wiresboy/HomeAutomationWifi/HomeAutoModuleBOM.xlsx

Qty | Value | Parts | Digikey | Price Each (q=10 or 50)
2 | 1uF | C1, C14 | 1276-1182-1-ND (http://www.digikey.com/product-detail/en/samsung-electro-mechanics-america-inc/CL10A105KP8NNNC/1276-1182-1-ND/3889268) | 0.0154
2 | 47pF | C16, C17 | 1276-1037-1-ND (http://www.digikey.com/product-detail/en/samsung-electro-mechanics-america-inc/CL10C470JB8NNNC/1276-1037-1-ND/3889123) | 0.0136
3 | .1uF | C2, C13, C15 | 1276-1258-1-ND (http://www.digikey.com/product-detail/en/samsung-electro-mechanics-america-inc/CL10F104ZO8NNNC/1276-1258-1-ND/3889344) | 0.0052
1 | 10uF | C3 | 1276-2405-1-ND (http://www.digikey.com/product-detail/en/samsung-electro-mechanics-america-inc/CL21A106KQCLRNC/1276-2405-1-ND/3890491) | 0.0334
1 | 5.6pF | C4 | 1276-2319-1-ND (http://www.digikey.com/product-detail/en/samsung-electro-mechanics-america-inc/CL10C5R6DB8NNNC/1276-2319-1-ND/3890405) | 0.0186
1 | 390pF: CC0805KRX7R9BB391 | C5 | 311-1193-1-ND (http://www.digikey.com/product-detail/en/yageo/CC0805KRX7R9BB391/311-1193-1-ND/372906) | 0.048
1 | 22uF: GRM21BR60J226ME39L | C6 | 490-1719-1-ND (http://www.digikey.com/product-detail/en/murata-electronics-north-america/GRM21BR60J226ME39L/490-1719-1-ND/587424) | 0.1
1 | 10uF: TMK316BJ106KL-T | C7 | 587-1337-1-ND (http://www.digikey.com/product-detail/en/taiyo-yuden/TMK316BJ106KL-T/587-1337-1-ND/931114) | 0.2074
1 | 22pF | C8 | 1276-2227-1-ND (http://www.digikey.com/product-detail/en/samsung-electro-mechanics-america-inc/CL10C220JB8NCNC/1276-2227-1-ND/3890313) | 0.0132
1 | 10pF | C9 | 1276-2156-1-ND (http://www.digikey.com/product-detail/en/samsung-electro-mechanics-america-inc/CL10C100JB8NNWC/1276-2156-1-ND/3890242) | 0.0118
1 | BLUE | D1 | 160-1647-1-ND (http://www.digikey.com/product-detail/en/lite-on-inc/LTST-C191TBKT/160-1647-1-ND/573587) | DNB - Huskies (0.2884)
1 | RED | D2 | 160-1447-1-ND (http://www.digikey.com/product-detail/en/lite-on-inc/LTST-C191KRKT/160-1447-1-ND/386836) | DNB - Huskies (0.1556)
1 | GREEN | D3 | 160-1446-1-ND (http://www.digikey.com/product-detail/en/lite-on-inc/LTST-C191KGKT/160-1446-1-ND/386834) | DNB - Huskies (0.1556)
1 | ORANGE (or yellow?) | D4 | 160-1434-1-ND (http://www.digikey.com/product-detail/en/lite-on-inc/LTST-C190KFKT/160-1434-1-ND/386812) | DNB - Huskies (0.1348)
1 | 51387-0578 | J1 | WM5462CT-ND (http://www.digikey.com/product-detail/en/molex-llc/0513870578/WM5462CT-ND/1624428) | 1.351
1 |  | J2 | DNB - personal
1 | PTSA_250_16 | J3 | 277-9150-ND (http://www.digikey.com/product-detail/en/phoenix-contact/1989887/277-9150-ND/3605147) | 1.79
3 | 22-23-2031 | J4 (+ JP1, JP2) | DNB - personal
2 |  | JP1, JP2 | S9001-ND (http://www.digikey.com/product-detail/en/sullins-connector-solutions/SPC02SYAN/S9001-ND/76375) | 0.0385
1 | 2.2uH: IHLP1212BZER2R2M11 | L1 | 541-1322-1-ND (http://www.digikey.com/product-detail/en/vishay-dale/IHLP1212BZER2R2M11/541-1322-1-ND/2425941) | 1.35
1 | MPZ1608S221ATA00 | L3 | 445-1565-1-ND (http://www.digikey.com/product-detail/en/tdk-corporation/MPZ1608S221ATA00/445-1565-1-ND/571895) | 0.079
1 | FA-20H | Q1 | SER4045CT-ND (http://www.digikey.com/product-detail/en/epson/FA-20H-40.0000MF10Z-K3/SER4045CT-ND/5175137) | 0.631
1 | 12K ±1% | R1 | 1276-4750-1-ND (http://www.digikey.com/product-detail/en/samsung-electro-mechanics-america-inc/RC1608F123CS/1276-4750-1-ND/3967722) | 0.007
2 | 27 | R10, R11 | 311-27.0HRCT-ND (http://www.digikey.com/product-detail/en/yageo/RC0603FR-0727RL/311-27.0HRCT-ND/730046) | 0.01
1 | 100K : ERJ-6ENF1003V | R3 | P100KCCT-ND (http://www.digikey.com/product-detail/en/panasonic-electronic-components/ERJ-6ENF1003V/P100KCCT-ND/119551) | 0.022
6 | 270 | R2, R4, R5, R8, R13, R14, R15 | 1276-5048-1-ND (http://www.digikey.com/product-detail/en/samsung-electro-mechanics-america-inc/RC1608J271CS/1276-5048-1-ND/3968020) | 0.0064
4 | 10K | R6, R7, R9, R12 | 311-10.0KHRCT-ND (http://www.digikey.com/scripts/DkSearch/dksus.dll?Detail&itemSeq=211240384&uq=636141553673519094) | 0.0057
1 | PTS645SM43SMTR92DEFAULT | SW1 | CKN9112CT-ND (http://www.digikey.com/product-detail/en/c-k-components/PTS645SM43SMTR92-LFS/CKN9112CT-ND/1146934) | DNB - Huskies (0.147)
1 | ESP8266 | U1 | DNB - Grid
1 | TPS62152RGTR | U2 | 296-43621-1-ND (http://www.digikey.com/product-detail/en/texas-instruments/TPS62152RGTR/296-43621-1-ND/5864761) | 1.881
1 | W25Q32FVSS | U3 | W25Q32FVSSIG-ND (http://www.digikey.com/product-detail/en/winbond-electronics/W25Q32FVSSIG/W25Q32FVSSIG-ND/4037404) | 0.5364
1 | FT231XS-R | U4 | 768-1129-1-ND (http://www.digikey.com/product-detail/en/ftdi-future-technology-devices-international-ltd/FT231XS-R/768-1129-1-ND/3029151) | 2.108
