wiresboy/HomeAutomationWifi/Silkscreen TL test 1.pdf

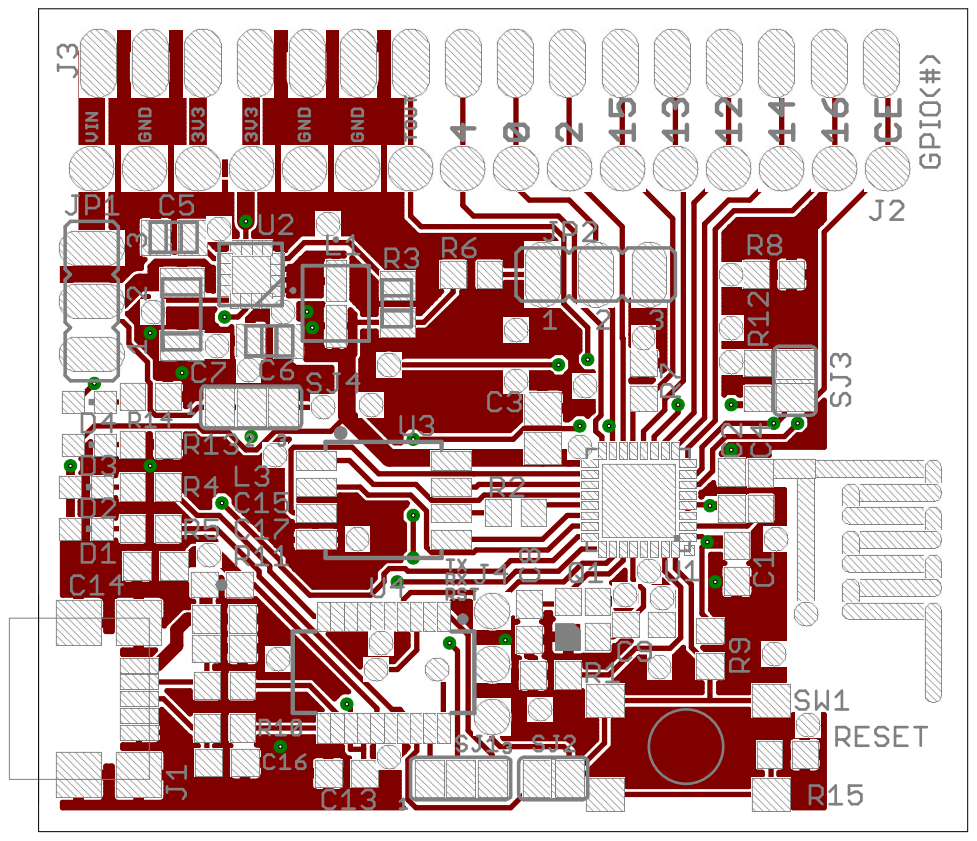
[picture p1: page 1]
