wiresboy/HomeAutomationWifi/HomeAutoModule.brd

## EAGLE design HomeAutoModule.brd (2016-10-31)

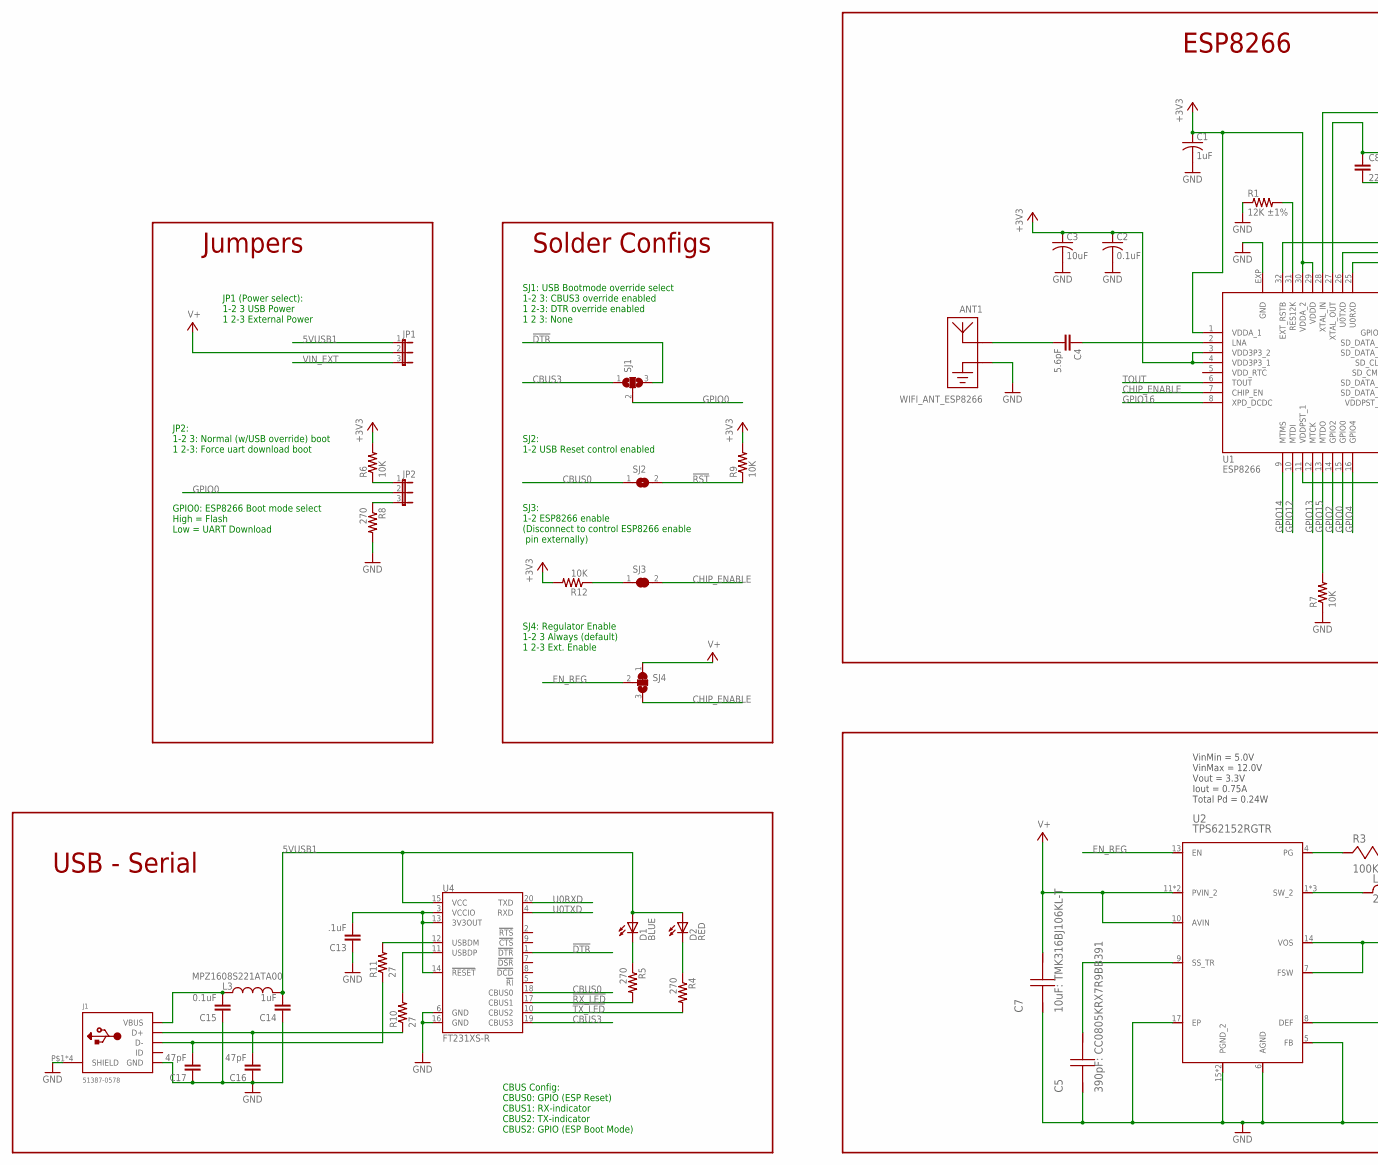
[picture p2: schematic HomeAutoModule.sch, part in row 1, column 1]

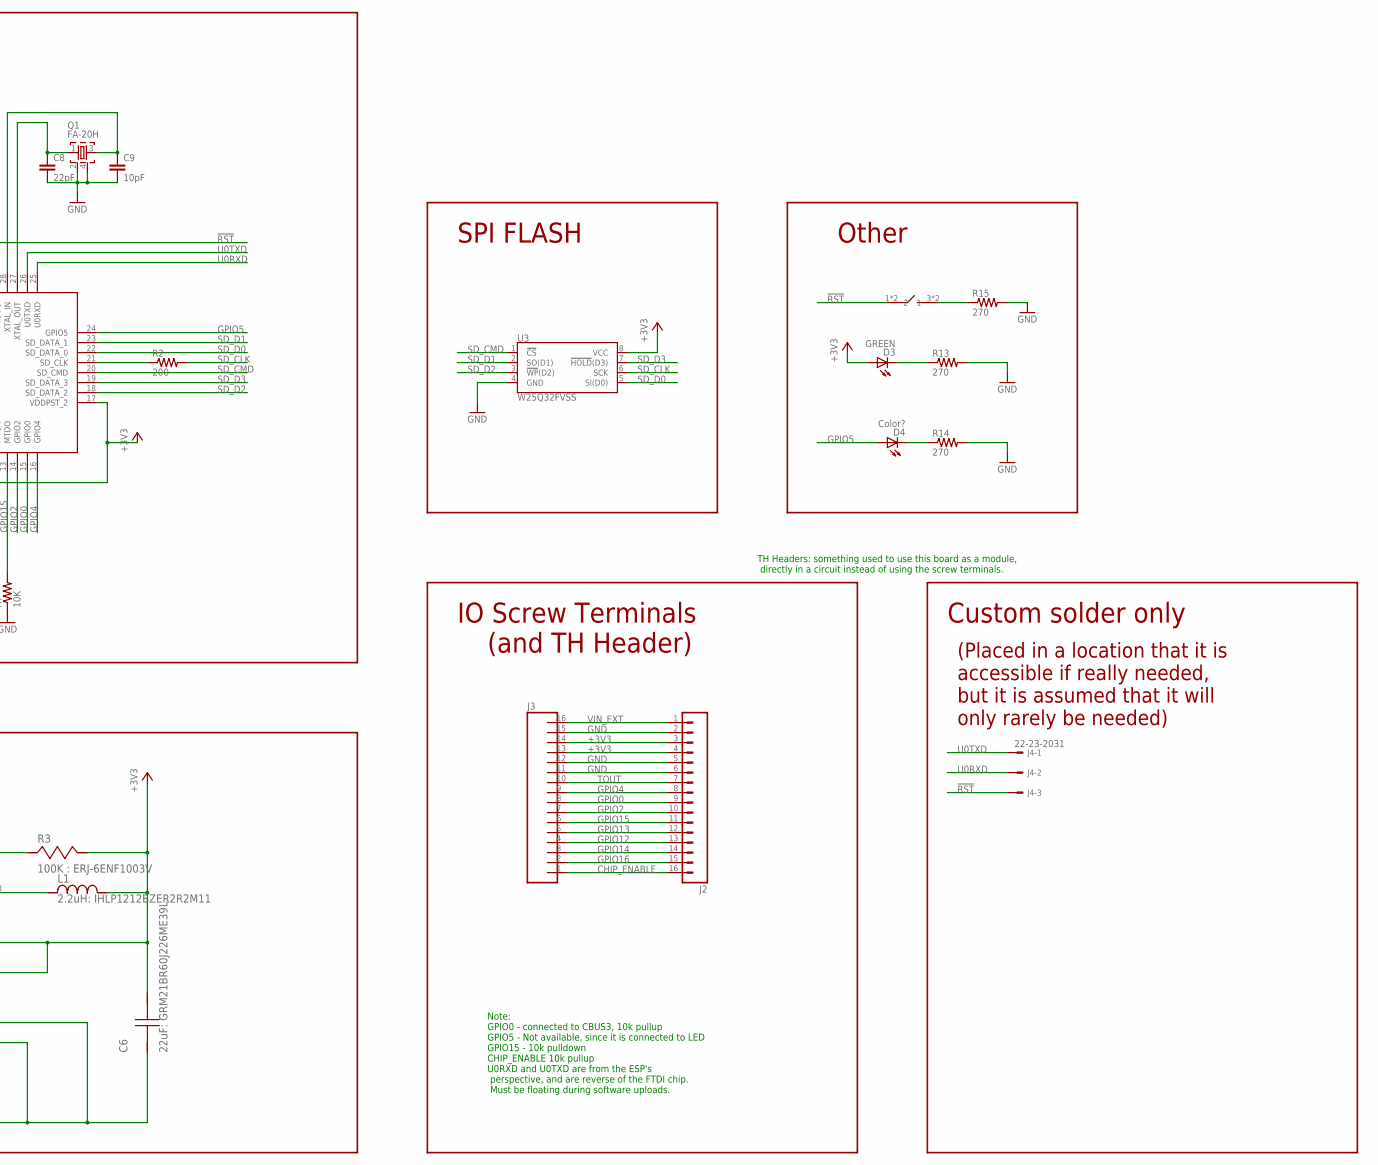
[picture p3: schematic HomeAutoModule.sch, part in row 1, column 2]

Parts:
ANT1: WIFI_ANT_ESP8266; ESP8266_ANT
C1: 1uF; C0603
C2, C15: 0.1uF; C0603K
C3: 10uF; C0805
C4: 5.6pF; C0603
C5: 390pF: CC0805KRX7R9BB391; 0805
C6: 22uF: GRM21BR60J226ME39L; 0805
C7: 10uF: TMK316BJ106KL-T; 1206
C8: 22pF; C0603
C9: 10pF; C0603
C13: .1uF; C0603K
C14: 1uF; C0603K
C16, C17: 47pF; C0603K
D1: BLUE; CHIPLED_0603
D2: RED; CHIPLED_0603
D3: GREEN; CHIPLED_0603
D4: Color?; CHIPLED_0603
J1: 51387-0578; USB-MINIB-0513870578
J2: M161X16_NO_SILK; 1X16_NO_SILK
J3: PTSA_250_16; PTSA_250_16_F
J4: 22-23-2031
JP1, JP2: JP2E; JP2
L1: 2.2uH: IHLP1212BZER2R2M11; IHLP-1212BZ
L3: MPZ1608S221ATA00; 0603
Q1: FA-20H
R1: 12K ±1%; R0603
R2: 200; R0603
R3: 100K : ERJ-6ENF1003V; 0805
R4, R5, R8, R13, R14, R15: 270; R0603
R6, R7, R9, R12: 10K; R0603
R10, R11: 27; R0603
SJ1: SJ2W; SJ_2
SJ2: SJ
SJ3: SJ_C
SJ4: SJ2_C; SJ_2_C
SW1: PTS645SM43SMTR92DEFAULT; PTS645SM43SMTR92
U1: ESP8266; HVQFN32
U2: TPS62152RGTR; S-PVQFN-N16
U3: W25Q32FVSS; SOIC-8
U4: FT231XS-R; SSOP20_L

Connections:
5VUSB1: C14.2, D1.A, D2.A, JP1.1, L3.2, U4.15 (VCC)
!DTR: SJ1.3, U4.1 (!DTR)
!RST: J4.3, R9.1, SJ2.2, SW1.1, SW1.2 (1), U1.32 (EXT_RSTB)
!RX_LED: R5.2, U4.17 (CBUS1)
!TX_LED: R4.2, U4.10 (CBUS2)
+3V3: C1.1, C2.1, C3.1, C6.1, D3.A, J2.3, J2.4, J3.13, J3.14, L1.2, R3.1, R6.2, R9.2, R12.2, U1.1 (VDDA_1), U1.3 (VDD3P3_2), U1.4 (VDD3P3_1), U1.11 (VDDPST_1), U1.17 (VDDPST_2), U1.29 (VDDD), U1.30 (VDDA_2), U2.7 (FSW), U2.14 (VOS), U3.8 (VCC)
CBUS0: SJ2.1, U4.18 (CBUS0)
CBUS3: SJ1.1, U4.19 (CBUS3)
CHIP_ENABLE: J2.16, J3.1, SJ3.2, SJ4.3, U1.7 (CHIP_EN)
EN_REG: SJ4.2, U2.13 (EN)
ESP_12K: R1.2, U1.31 (RES12K)
GND: ANT1.GND, C1.2, C2.2, C3.2, C5.2, C6.2, C7.2, C8.2, C9.2, C13.1, C14.1, C15.1, C16.1, C17.1, J1.GND, J1.P$1 (SHIELD), J1.P$2 (SHIELD), J1.P$3 (SHIELD), J1.P$4 (SHIELD), J2.2, J2.5, J2.6, J3.11, J3.12, J3.15, Q1.2, Q1.4, R1.1, R7.1, R8.2, R13.2, R14.2, R15.2, U1.EXP (GND), U2.5 (FB), U2.6 (AGND), U2.8 (DEF), U2.15 (PGND_2), U2.16 (PGND_2), U2.17 (EP), U3.4 (GND), U4.6 (GND), U4.16 (GND)
GPIO0: J2.9, J3.8, JP2.2, SJ1.2, U1.15 (GPIO0)
GPIO2: J2.10, J3.7, U1.14 (GPIO2)
GPIO4: J2.8, J3.9, U1.16 (GPIO4)
GPIO5: D4.A, U1.24 (GPIO5)
GPIO12: J2.13, J3.4, U1.10 (MTDI)
GPIO13: J2.12, J3.5, U1.12 (MTCK)
GPIO14: J2.14, J3.3, U1.9 (MTMS)
GPIO15: J2.11, J3.6, R7.2, U1.13 (MTDO)
GPIO16: J2.15, J3.2, U1.8 (XPD_DCDC)
LNA: C4.1, U1.2 (LNA)
unnamed: R2.1, U1.21 (SD_CLK)
unnamed: ANT1.ANT, C4.2
unnamed: JP2.3, R8.1
unnamed: C5.1, U2.9 (SS_TR)
unnamed: JP2.1, R6.1
unnamed: R3.2, U2.4 (PG)
unnamed: L1.1, U2.1 (SW_2), U2.2 (SW_2), U2.3 (SW_2)
unnamed: C13.2, U4.3 (VCCIO), U4.13 (3V3OUT), U4.14 (!RESET)
unnamed: D2.C, R4.1
unnamed: D1.C, R5.1
unnamed: R11.2, U4.12 (USBDM)
unnamed: R12.1, SJ3.1
unnamed: R10.2, U4.11 (USBDP)
unnamed: D3.C, R13.1
unnamed: D4.C, R14.1
unnamed: R15.1, SW1.3 (2), SW1.4 (2)
SD_CLK: R2.2, U3.6 (SCK)
SD_CMD: U1.20 (SD_CMD), U3.1 (!CS!)
SD_D0: U1.22 (SD_DATA_0), U3.5 (SI(D0))
SD_D1: U1.23 (SD_DATA_1), U3.2 (SO(D1))
SD_D2: U1.18 (SD_DATA_2), U3.3 (!WP!(D2))
SD_D3: U1.19 (SD_DATA_3), U3.7 (!HOLD!(D3))
TOUT: J2.7, J3.10, U1.6 (TOUT)
U0RXD: J4.2, U1.25 (U0RXD), U4.20 (TXD)
U0TXD: J4.1, U1.26 (U0TXD), U4.4 (RXD)
USB_D+: C16.2, J1.D+, R10.1
USB_D-: C17.2, J1.D-, R11.1
USB_VBUS: C15.2, J1.VBUS, L3.1
V+: C7.1, JP1.2, SJ4.1, U2.10 (AVIN), U2.11 (PVIN_2), U2.12 (PVIN_2)
VIN_EXT: J2.1, J3.16, JP1.3
XTAL_IN: C9.1, Q1.3, U1.28 (XTAL_IN)
XTAL_OUT: C8.1, Q1.1, U1.27 (XTAL_OUT)

Notes on the sheet:
VinMin = 5.0V VinMax = 12.0V Vout = 3.3V Iout = 0.75A Total Pd = 0.24W
CBUS Config: CBUS0: GPIO (ESP Reset) CBUS1: RX-indicator CBUS2: TX-indicator CBUS2: GPIO (ESP Boot Mode)
GPIO0: ESP8266 Boot mode select High = Flash Low = UART Download
JP2: 1-2 3: Normal (w/USB override) boot 1 2-3: Force uart download boot
SJ1: USB Bootmode override select 1-2 3: CBUS3 override enabled 1 2-3: DTR override enabled 1 2 3: None
SJ2: 1-2 USB Reset control enabled
SJ3: 1-2 ESP8266 enable (Disconnect to control ESP8266 enable pin externally)
Solder Configs
JP1 (Power select): 1-2 3 USB Power 1 2-3 External Power
Jumpers
IO Screw Terminals
Note: GPIO0 - connected to CBUS3, 10k pullup GPIO5 - Not available, since it is connected to LED GPIO15 - 10k pulldown CHIP_ENABLE 10k pullup U0RXD and U0TXD are from the ESP's perspective, and are reverse of the FTDI chip. Must be floating during software uploads.
SJ4: Regulator Enable 1-2 3 Always (default) 1 2-3 Ext. Enable
Custom solder only
SPI FLASH
ESP8266
USB - Serial
Other
(and TH Header)
TH Headers: something used to use this board as a module, directly in a circuit instead of using the screw terminals.
(Placed in a location that it is accessible if really needed, but it is assumed that it will only rarely be needed)

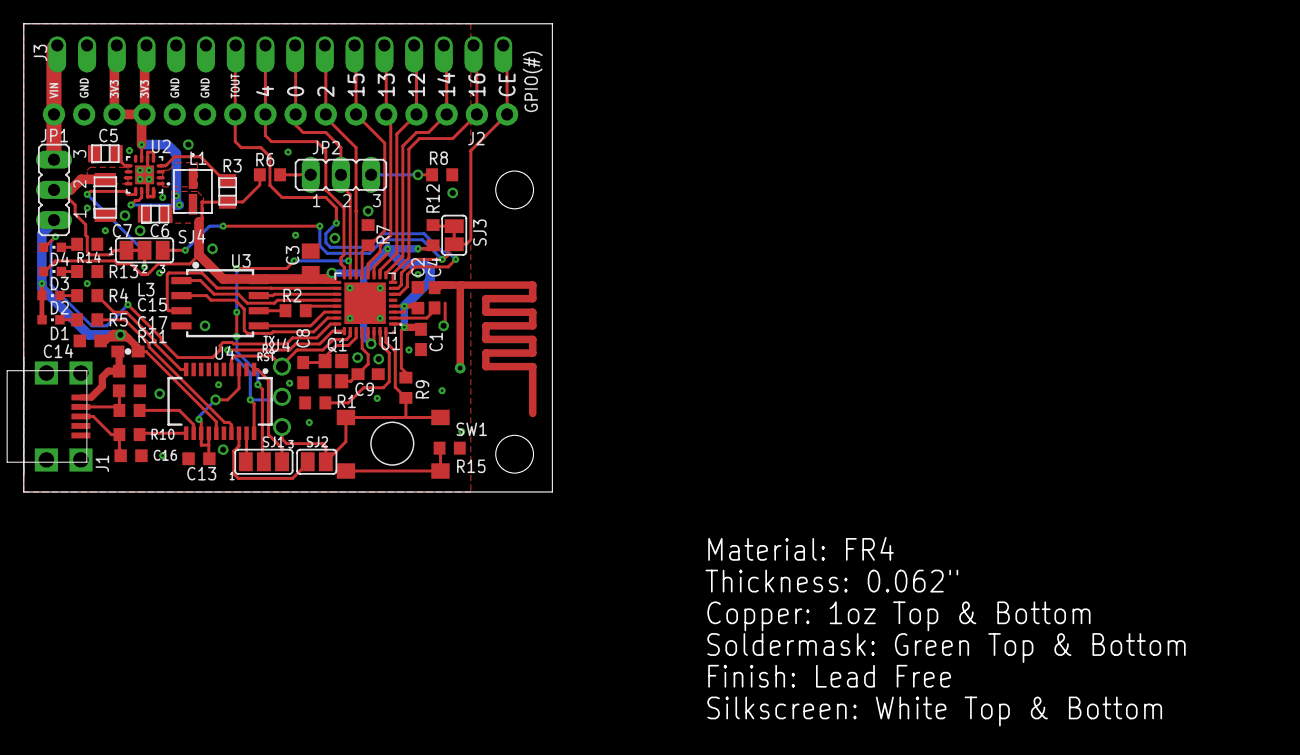
[picture p4: board HomeAutoModule.brd from above]

Board: 2 copper layers, 44.5 x 39.4 mm, 53 parts (0 on the bottom side), 54 nets.

Other parts of the board:
DRILEGEND: DRILEGEND
