wiresboy/HomeAutomationWifi/(commit log)

2016-10-02 Found open source antenna library
    [module.sch]
2016-10-03 Implemented ESP8266 basic layout
    [module.sch]
2016-10-04 Added TI Power Regulator
    Based on a WEBench design from TI.
    [module.sch]
2016-10-05 Fixed antenna library
2016-10-14 Added USB, control jumpers
    [module.sch]
2016-10-14 Prep for IO use
    [module.sch]
2016-10-15 Added crystal, more USB config
    [module.sch]
2016-10-15 Refactored schematic for readability
    Also added SPI flash, marked IO to be used at screw terminals
    [module.sch]
2016-10-15 Added place-holders for "Other" category
    (GPIO LED, reset button)
    [module.sch]
2016-10-15 Clarified use of UART io lines
    [module.sch]
2016-10-16 Clarified comments
    [module.sch]
2016-10-18 Fixed Mr. Emges suggestions, Reset Button
    [module.sch]
2016-10-18 Renamed Module to HomeAutoBoard
    [HomeAutoModule.sch]
2016-10-21 Started board layout
    [HomeAutoModule.brd, HomeAutoModule.sch]
2016-10-22 Ran traces for flash chip
    [HomeAutoModule.brd]
2016-10-22 USB Routed
    [HomeAutoModule.brd]
2016-10-22 Connected many units
    [HomeAutoModule.brd]
2016-10-22 Rearranged antenna to fit reset button more easily
    It didn't work. May need to find a new button, in which case the antenna
    could be put back.
    [HomeAutoModule.brd]
2016-10-22 reset button routing complete
    [HomeAutoModule.brd]
2016-10-22 Routed power regulator
    3.3v bus still needs routing.
    [HomeAutoModule.brd, HomeAutoModule.sch]
2016-10-23 1st layout pass complete
    Still need all of the connectors, in both schematic and board layout.
    Making sure the core idea in this design is ok, then will proceed.
    [HomeAutoModule.brd, HomeAutoModule.sch]
2016-10-25 Many various tweaks
    All GPIO that I plan on making easily accessible is now routed to the
    edge of the board.
    I am still debating whether I want to keep the UART0_TX/UART0_RX and RST
    lines available, since for the most part they probably wouldn't need to
    be accessed after development, and during the physical button and USB
    could be used.
    [HomeAutoModule.brd, HomeAutoModule.sch]
2016-10-25 Fixed C1 placement for ESP8266
    still may need to adjust C2
    [HomeAutoModule.brd, HomeAutoModule.sch]
2016-10-26 Fixed comments from feedback #3
    [HomeAutoModule.brd]
2016-10-26 Fixed power regulator layout
    per feedback #4
    [HomeAutoModule.brd]
2016-10-26 Better ground via connections
    [HomeAutoModule.brd]
2016-10-26 Made some vias smaller
    Only the ones that were particularly annoying to place, and the via in
    pad ones.
    [HomeAutoModule.brd]
2016-10-26 Dennnis update
    R1, C1, C4, R9 adjusted for better power decoupling cap return paths
    [HomeAutoModule.brd]
2016-10-27 Rerouted GPIO0 to not go under the antenna
    Also made a bunch of the vias smaller, which allowed for cleaner routing
    in many places.
    [HomeAutoModule.brd]
2016-10-27 Organised schematic for future connector connection
    [HomeAutoModule.brd, HomeAutoModule.sch]
2016-10-28 Added connectors to layout, schematic.
    [HomeAutoModule.brd, HomeAutoModule.sch]
2016-10-28 Compacted board layout
    [HomeAutoModule.brd]
2016-10-28 recalculated drc
    [HomeAutoModule.brd]
2016-10-29 Layout out silkscreen layer
    [HomeAutoModule.brd, HomeAutoModule.sch]
2016-10-29 Updated DRU, slight modifications to match it.
    [HomeAutoModule.brd]
2016-10-29 Added hole, pcb annotations
    [DRILEGEND.CFG, HomeAutoModule.brd, HomeAutoModule.sch]
2016-10-29 Generated Gerbers
2016-10-29 Fixed QFN layout for U2
    [HomeAutoModule.brd, HomeAutoModule.sch]
2016-10-31 Gerber update
2016-10-31 Updated 2 more gerbers
2016-10-31 Final gerbers
    [HomeAutoModule.brd, HomeAutoModule.sch]
2016-11-22 Final BOM
    [HomeAutoModuleBOM.csv, HomeAutoModuleBOM.xlsx]
2016-11-27 More MQTT experiments
    Likely going to scrap MQTT, since a REST server doesn't require extra
    hardware.
    [TrueTRIAC.lua, init.lua, server.lua]
2016-12-11 Fixed some stuff
    It appears that the UPNP service is not compatible with the TrendNet
    router - so this now uses a linksys router.
    Auto-run on boot now works, AP must be connected in the first ~1 minute,
    otherwise a reboot is required.
    Todo: make it so that reboots are not required.
    [init.lua]
